jflorchi/micro_sas/board/board.png

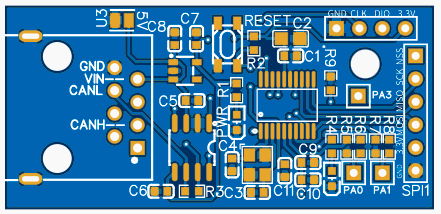
board/board.png
