jflorchi/micro_sas/board/BOM.csv

ID | Name | Designator | Footprint | Quantity | Manufacturer Part | Manufacturer | Supplier | Supplier Part | Price | Pins | 3DModel | JLCPCB Part Class | Contributor | Resistance | Resistance (Ohms) | link
1 | 10K | R9,R2 | R0603 | 2 | RC0603JR-0710KL | YAGEO | LCSC | C99198 | 0.001 | 2 | R0603_L1.6-W0.8-H0.8 | Extended Part | lcsc | 10kΩ |  | https://www.mouser.in/datasheet/2/447/PYu_RT_1_to_0_01_RoHS_L_11-1669912.pdf
2 | PADPAD123 | U3 | PADPAD | 1 |  |  |  |  |  | 2 |  |  | imran02
3 | HDR-M-2.54_1x1 | PA0,PA1,PA3 | HDR-M-2.54_1X1 | 3 |  |  | LCSC | C81276 | 0.007 | 1 | HDR-M-2.54_1x1 |  | LCEDA_Lib
4 | 3.6kΩ | R5,R7 | R0603 | 2 | 0603WAF3601T5E | UniOhm | LCSC | C22980 | 0.001 | 2 | R0603_L1.6-W0.8-H0.8 | Basic Part | lcsc |  | 3.6K | https://www.mouser.in/datasheet/2/447/PYu_RT_1_to_0_01_RoHS_L_11-1669912.pdf
5 | 9.1kΩ | R6,R8 | R0603 | 2 | 0603WAF9101T5E | UniOhm | LCSC | C23260 | 0.002 | 2 | R0603_L1.6-W0.8-H0.8 | Basic Part | lcsc |  | 9.1K | https://www.mouser.in/datasheet/2/447/PYu_RT_1_to_0_01_RoHS_L_11-1669912.pdf
6 | 100nF | C1,C11 | C0603 | 2 | CL10B104KB8NNNC | SAMSUNG | LCSC | C1591 | 0.003 | 2 | C0603_L1.6-W0.8-H0.8 | Extended Part | lcsc |  |  | https://item.szlcsc.com/362304.html
7 | 8pF | C3,C4 | C0603 | 2 | 0603CG8R0C500NT | FH | LCSC | C36508 | 0.003 | 2 | C0603_L1.6-W0.8-H0.8 | Extended Part | lcsc |  |  | https://item.szlcsc.com/362304.html
8 | 19-217/R6C-AL1M2VY/3T | PWR,LED2 | LED0603-R-RD | 2 | 19-217/R6C-AL1M2VY/3T | EVERLIGHT | LCSC | C72044 | 0.016 | 2 | LED0603_L1.6-W0.8-H0.6 | Extended Part | lcsc |  |  | https://lcsc.com/product-detail/Light-Emitting-Diodes-LED_Hubei-KENTO-Elec-0603-Green_C12624.html
9 | 220Ω | R1,R4 | R0603 | 2 | 0603WAJ0221T5E | UniOhm | LCSC | C1226 | 0.001 | 2 | R0603_L1.6-W0.8-H0.8 | Extended Part | lcsc |  | 220 | https://www.mouser.in/datasheet/2/447/PYu_RT_1_to_0_01_RoHS_L_11-1669912.pdf
10 | 10nF | C9 | C0603 | 1 | CL10B103KB8NNNC | SAMSUNG | LCSC | C1589 | 0.003 | 2 | C0603_L1.6-W0.8-H0.8 | Extended Part | lcsc |  |  | https://item.szlcsc.com/362304.html
11 | 1uF | C10,C8 | C0603 | 2 | CS1608X7R105K250NRB | Samwha Capacitor | LCSC | C513775 | 0.007 | 2 | C0603_L1.6-W0.8-H0.8 | Extended Part | LCSC |  |  | https://item.szlcsc.com/362304.html
12 | 100nF | C5,C6 | C0603 | 2 | CS1608X7R104K500NRB | SAMWHA(三和) | LCSC | C2909627 | 0.003 | 2 | C0603_L1.6-W0.8-H0.8 | Extended Part | LCSC |  |  | https://item.szlcsc.com/362304.html
13 | 4.7uF | C2 | C0805 | 1 | CS2012X5R475K500NRE | Samwha Capacitor | LCSC | C513770 | 0.027 | 2 | C0805_L2.0-W1.3-H1.3 |  | LCSC |  |  | https://item.szlcsc.com/373011.html
14 | 2.2uF | C7 | C0603 | 1 | CS1608X7R225K100NRB | Samwha Capacitor | LCSC | C516003 | 0.012 | 2 | C0603_L1.6-W0.8-H0.8 | Extended Part | LCSC |  |  | https://item.szlcsc.com/362304.html
15 | TJA1042T/3/1J | CAN_TRANS1 | SOIC-8_L5.0-W4.0-P1.27-LS6.0-BL | 1 | TJA1042T/3/1J | NXP Semicon | LCSC | C132227 | 1.223 | 8 | SOIC-8_L4.9-W3.9-H1.7-LS6.0-P1.27 | Extended Part | LCSC |  |  | https://item.szlcsc.com/417287.html
16 | 120Ω | R3 | R0603 | 1 | ERA3AEB121V | PANASONIC | LCSC | C491112 | 0.079 | 2 | R0603_L1.6-W0.8-H0.8 | Extended Part | LCSC |  |  | https://www.mouser.in/datasheet/2/447/PYu_RT_1_to_0_01_RoHS_L_11-1669912.pdf
17 | KH-RJ45-58-8P8C | RJ1 | RJ45-TH_KH-RJ45-58-8P8C | 1 | KH-RJ45-58-8P8C | kinghelm(金航标) | LCSC | C2683360 | 0.274 | 10 | RJ45-TH_KH-RJ45-58-8P8C | Extended Part | LCSC |  |  | https://atta.szlcsc.com/upload/public/pdf/source/20210106/C2683360_ED9F3988DA748C26BF57E22522EFC041.pdf
18 | PERIF_1 | SPI1 | HDR-F-2.54_1X6 | 1 |  |  | LCSC | C40877 | 0.069 | 6 | HDR-F-2.54_1x6 |  | LCEDA_Lib
19 | STM32F042F4P6 | U1 | TSSOP-20_L6.5-W4.4-P0.65-LS6.4-BL | 1 | STM32F042F4P6 | STMicroelectronics | LCSC | C81002 | 5.88 | 20 | TSSOP-20_L6.5-W4.4-H1.0-LS6.4-P0.65 | Extended Part | 官方封装库 |  |  | https://item.szlcsc.com/8600.html
20 | TPMIC5233-3.3YM5 | U2 | SOT-23-5_L3.0-W1.7-P0.95-LS2.8-BR | 1 | TPMIC5233-3.3YM5 | TECH PUBLIC(台舟) | LCSC | C2937037 | 0.285 | 5 | SOT-23-5_L2.9-W1.6-H1.1-LS2.8-P0.95 |  | LCSC |  |  | https://item.szlcsc.com/236104.html
21 | 12MHz 9pF | X1 | OSC-SMD_4P-L3.2-W2.5-BL | 1 | X322512MLB4SI | YXC | LCSC | C112971 | 0.086 | 4 | OSC-SMD_4P-L3.2-W2.5-H1.0 | Extended Part | 官方封装库 |  |  | https://item.szlcsc.com/15866.html
22 | TS-1145A-B-A | RESET | SW-SMD_4P-L4.2-W3.2-P2.15-LS5.2 | 1 | TS-1145A-B-A | XKB Enterprise | LCSC | C318904 | 0.053 | 4 | SW-SMD_4P-L4.2-W3.2-P2.15-LS5.2 | Extended Part | LCSC |  |  | https://item.szlcsc.com/617092.html
23 | HDR-F-2.54_1x4 | STLINK | HDR-F-2.54_1X4 | 1 |  |  | LCSC | C225501 | 0.084 | 4 | HDR-F-2.54_1x4 |  | LCEDA_Lib
