jflorchi/micro_sas/board/schematic.pdf

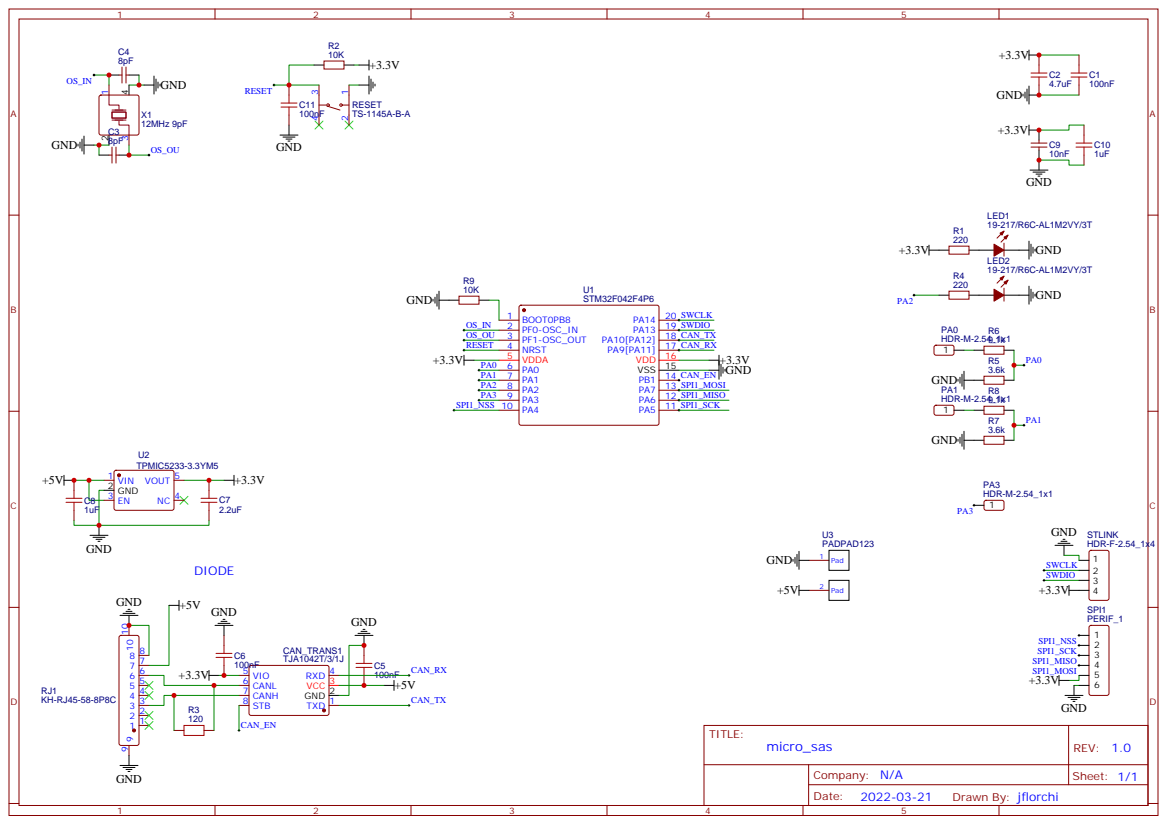
[picture p2: page 1]
