jflorchi/micro_sas/firmware/Core/Src/main.c

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
/* Includes ------------------------------------------------------------------*/
#include "main.h"

/* USER CODE BEGIN PTD */
#define ENABLE_CAN_TRANSCEIVER() HAL_GPIO_WritePin(GPIOB, GPIO_PIN_1, GPIO_PIN_RESET)
#define LED_OFF() HAL_GPIO_WritePin(GPIOA, GPIO_PIN_2, GPIO_PIN_RESET)
#define LED_ON() HAL_GPIO_WritePin(GPIOA, GPIO_PIN_2, GPIO_PIN_SET)

#define SET_ERROR(n) errors |= 1UL << n
#define CLEAR_ERROR(n) errors &= ~(1UL << n)

#define ABS(x) ((x) > 0 ? (x) : -(x))

#define __AS5048A2_CS_ENABLE() HAL_GPIO_WritePin(GPIOA, GPIO_PIN_4, GPIO_PIN_RESET)
#define __AS5048A2_CS_DISABLE() HAL_GPIO_WritePin(GPIOA, GPIO_PIN_4, GPIO_PIN_SET)

#define __Read_NOP 0xc000
#define __Read_Clear_Error_Flag 0x4001
#define __Read_Angle 0xffff
/* USER CODE END PTD */

 CAN_HandleTypeDef hcan;

SPI_HandleTypeDef hspi1;

void SystemClock_Config(void);
static void MX_GPIO_Init(void);
static void MX_SPI1_Init(void);
static void MX_CAN_Init(void);
/* USER CODE BEGIN PFP */

uint16_t getRawRotation(void);
uint32_t sendCAN(uint16_t id, uint8_t buffer[], uint8_t len);
void processCAN(CAN_HandleTypeDef *hcan, uint32_t mailbox);
int getChecksum(uint8_t *msg, uint8_t len, uint16_t addr);
void attachChecksum(uint16_t id, uint8_t len, uint8_t *msg);
uint8_t isDeadFace(uint8_t buf[], uint8_t len);

/* USER CODE END PFP */

/* USER CODE BEGIN 0 */
uint8_t errors = 0;

CAN_FilterTypeDef     canfil;
CAN_RxHeaderTypeDef   rxHeader;
uint8_t               rxBuffer[8];
CAN_TxHeaderTypeDef txHeader;
uint32_t  txMailbox;

uint8_t ignition = 0;
uint32_t lastSeen = 0;

uint16_t current_position;
uint16_t last_position;
int16_t position_movement;
int32_t rotational_position;
uint16_t bitshift_cur_pos;
uint16_t bitshift_last_pos;
int16_t bitshift_pos_delta;

uint16_t counter = 0;

uint16_t SPI_TX_DATA[4] = {__Read_Clear_Error_Flag, __Read_NOP, __Read_Angle, __Read_NOP};
uint16_t SPI_RX_DATA[4] = {0};
const uint8_t op_num = 4;
uint16_t origin_value = 0;
uint8_t i;
uint8_t TXD[4] = {0x55, 0xAA, 0x00, 0x00};
uint16_t post_process_value = 0;

/* USER CODE END 0 */

/**
  * @brief  The application entry point.
  * @retval int
  */
int main(void)
{
  /* MCU Configuration--------------------------------------------------------*/

  /* Reset of all peripherals, Initializes the Flash interface and the Systick. */
  HAL_Init();

  /* Configure the system clock */
  SystemClock_Config();

  /* Initialize all configured peripherals */
  MX_GPIO_Init();
  MX_SPI1_Init();
  MX_CAN_Init();
  /* USER CODE BEGIN 2 */
  ENABLE_CAN_TRANSCEIVER();

  LED_OFF();
  if (HAL_CAN_Start(&hcan) != HAL_OK) {
	  LED_ON();
  }
  HAL_CAN_ActivateNotification(&hcan, CAN_IT_RX_FIFO0_MSG_PENDING);
  HAL_CAN_ActivateNotification(&hcan, CAN_IT_RX_FIFO1_MSG_PENDING);

  current_position = getRawRotation();
  last_position = current_position;
  rotational_position = 0;
  /* USER CODE END 2 */

  /* Infinite loop */
  /* USER CODE BEGIN WHILE */
  while (1) {
	  if (HAL_GetTick() - lastSeen > 500) {
		  ignition = 0;
	  }

	  current_position = getRawRotation();
	  bitshift_cur_pos = current_position << 2;
	  bitshift_last_pos = last_position << 2;
	  bitshift_pos_delta = (bitshift_cur_pos - bitshift_last_pos); // Calculate the encoder "ticks" moved since the last reading - in bitshift math
	  position_movement = bitshift_pos_delta >> 2; // Calculate the encoder "ticks" moved since the last reading - converting bitshift math
	  rotational_position += position_movement; // Update the absolute position values.
	  last_position = current_position;

	  if (rotational_position > 49149 || rotational_position < -49149) { // check sane (3 full rotations)
		  SET_ERROR(2);
	  } else {
		  CLEAR_ERROR(2);
	  }

	  if (ignition == 1) {
		  LED_ON();
		  if (counter % 10 == 0) {
			  int raw = rotational_position;
			  uint8_t txBuffer[] = {(raw >> 24) & 0xFF, (raw >> 16) & 0xFF,
					  	  	  	  	  (raw >> 8) & 0xFF, raw & 0xFF,
									  0x00, 0x00, 0x00, 0x00};
			  sendCAN(0x23, txBuffer, 8); // steering angle message
		  }

		  if (counter == 100) {
			  uint8_t errBuffer[1] = {errors};
			  sendCAN(0x231, errBuffer, 1); // error flags
			  counter = 0;
		  }

		  counter++;
		  HAL_Delay(1);
	  } else {
		  LED_OFF();
		  HAL_Delay(500);
	  }

    /* USER CODE END WHILE */

    /* USER CODE BEGIN 3 */
  }
  /* USER CODE END 3 */
}

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
/* USER CODE BEGIN 4 */

uint16_t getRawRotation() {
	for (i = 0; i < op_num; i++) {
		__AS5048A2_CS_ENABLE();
		HAL_SPI_TransmitReceive(&hspi1, (uint8_t*) &SPI_TX_DATA[i], (uint8_t*) &SPI_RX_DATA[i], 1, 2710);
		__AS5048A2_CS_DISABLE();
	}
	return SPI_RX_DATA[3] & 0x3fff;
}

uint32_t sendCAN(uint16_t id, uint8_t buffer[], uint8_t len) {
	CAN_TxHeaderTypeDef header;

	header.IDE = CAN_ID_STD;
	header.RTR = CAN_RTR_DATA;
	header.TransmitGlobalTime = DISABLE;
	header.DLC = len;
	header.StdId = id;

	uint32_t mailbox;

	if (HAL_CAN_GetTxMailboxesFreeLevel(&hcan) > 0) {
		uint8_t res = HAL_CAN_AddTxMessage(&hcan, &header, buffer, &mailbox);
		if (res != HAL_OK) {
			SET_ERROR(0);
		} else {
			CLEAR_ERROR(0);
		}
	} else {
		if (HAL_CAN_IsTxMessagePending(&hcan, txMailbox)) {
			SET_ERROR(1);
		}
	}

	return mailbox;
}

void HAL_CAN_RxFifo0MsgPendingCallback(CAN_HandleTypeDef *hcan) {
	processCAN(hcan, CAN_RX_FIFO0);
}

void HAL_CAN_RxFifo1MsgPendingCallback(CAN_HandleTypeDef *hcan) {
	processCAN(hcan, CAN_RX_FIFO1);
}

void processCAN(CAN_HandleTypeDef *hcan, uint32_t mailbox) {
	CAN_RxHeaderTypeDef tmp;
	uint8_t data[8];
	HAL_CAN_GetRxMessage(hcan, mailbox, &tmp, data);
	if (tmp.StdId == 0x230 && isDeadFace(data, tmp.DLC)) {
		rotational_position = 0;
	}
	if (tmp.StdId == 0x001) {
		ignition = 1;
		lastSeen = HAL_GetTick();
	}
}

int getChecksum(uint8_t *msg, uint8_t len, uint16_t addr) {
    uint8_t checksum = 0;
    checksum = ((addr & 0xFF00) >> 8) + (addr & 0x00FF) + len + 1;
    for (int ii = 0; ii < len; ii++) {
        checksum += (msg[ii]);
    }
    return checksum;
}

uint8_t isDeadFace(uint8_t buf[], uint8_t len) {
	if (len != 8) {
		return 0;
	}
	return buf[0] = 0xD && buf[1] == 0xE && buf[2] == 0xA && buf[3] ==0xD
			&& buf[4] == 0xF && buf[5] == 0xA && buf[6] == 0xC && buf[7] == 0xE;
}



/* USER CODE END 4 */
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
