jflorchi/micro_sas/firmware/micro_sas.ioc

Mcu.UserName=STM32F042F4Px
PA11.Signal=CAN_RX
PA12.Signal=CAN_TX
PA13.Signal=SYS_SWDIO
PA14.Signal=SYS_SWCLK
PA2.Signal=GPIO_Output
PA4.Signal=GPIO_Output
PA5.Signal=SPI1_SCK
PA6.Signal=SPI1_MISO
PA7.Signal=SPI1_MOSI
PB1.Signal=GPIO_Output
PF0-OSC_IN.Signal=RCC_OSC_IN
PF1-OSC_OUT.Signal=RCC_OSC_OUT
