jflorchi/micro_sas/(commit log)

2022-06-03 add board stuff
    [BOM.csv, pnp.csv]
2022-06-03 add board picture
